LTU-RAI/mav_sbus_bridge/README.md

# SBUS bridge for controlling Betaflight via ROS

A simple SBUS bridge (in/out) for controlling betaflight (or other FCUs) via ROS/PC over USB.

Design specifications:

* Simple 2-layer, 0.3mm vias, 0.2mm trace/space rules
* SBUS input can be inverted via solder jumper
* The USB is also available on header for direct soldering
* M2 mounting hole

---

## Contributors

List of contributors in alphabetical order:

* Emil Fresk ([@korken89](https://github.com/korken89))

---

## License

The hardware is OSHW using the Cern-OHL license.
