LTU-RAI/mav_sbus_bridge/(commit log)

2019-04-02 Sbus bridge
    [mav_sbus_bridge.kicad_pcb, mav_sbus_bridge.sch]
2019-04-03 Added gerbers
    [mav_sbus_bridge-B_Cu.gbr, mav_sbus_bridge-B_Mask.gbr, mav_sbus_bridge-B_Paste.gbr, mav_sbus_bridge-B_SilkS.gbr, mav_sbus_bridge-Edge_Cuts.gbr, mav_sbus_bridge-F_Cu.gbr, mav_sbus_bridge-F_Mask.gbr, mav_sbus_bridge-F_Paste.gbr]
2019-04-06 Added mounting hole, minor fixes
    [mav_sbus_bridge.kicad_pcb, mav_sbus_bridge.sch]
2019-04-06 Updated XOR gate
    [mav_sbus_bridge.kicad_pcb, mav_sbus_bridge.sch]
2019-04-06 Updated USB connector
    [mav_sbus_bridge.sch]
2019-04-12 Now smaller and with castellated vias
    [mav_sbus_bridge-B_Cu.gbr, mav_sbus_bridge-B_Mask.gbr, mav_sbus_bridge-B_Paste.gbr, mav_sbus_bridge-B_SilkS.gbr, mav_sbus_bridge-Edge_Cuts.gbr, mav_sbus_bridge-F_Cu.gbr, mav_sbus_bridge-F_Mask.gbr, mav_sbus_bridge-F_Paste.gbr]
